bigjosh/Vibe-V2/board/Images/readme.md

These images are just here to enable GITHUB's visual diff.

They were created with the very handy CircuitPeople tool.
