bigjosh/Vibe-V2/board/Images/BoardOutline.gbr.png

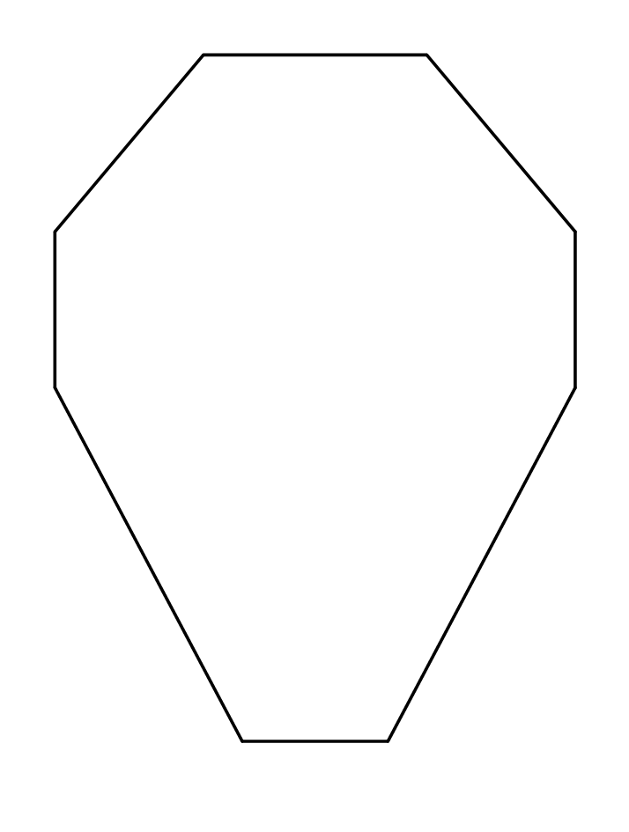
board/Images/BoardOutline.gbr.png
