bigjosh/Vibe-V2/board/Images/Bottom.gbr.png

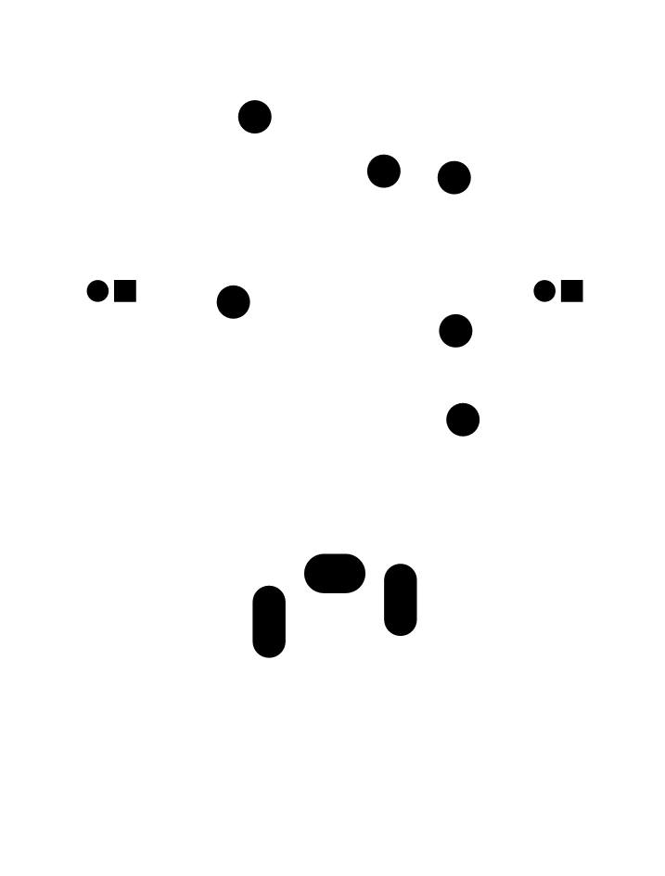
board/Images/Bottom.gbr.png
