bigjosh/Vibe-V2/board/Images/BottomMask.gbr.png

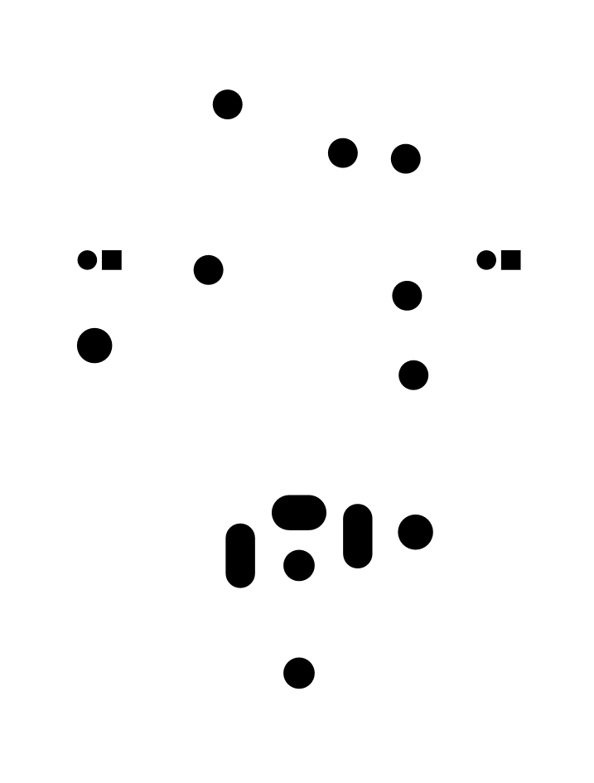
board/Images/BottomMask.gbr.png
