bigjosh/Vibe-V2/board/Images/BottomSilk.gbr.png

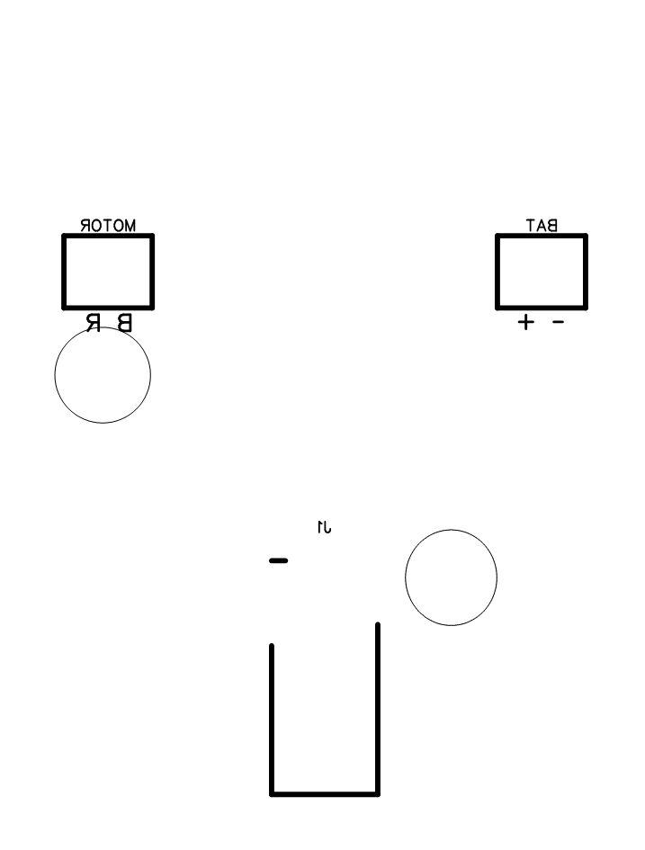
board/Images/BottomSilk.gbr.png
