bigjosh/Vibe-V2/board/Images/Top.gbr.png

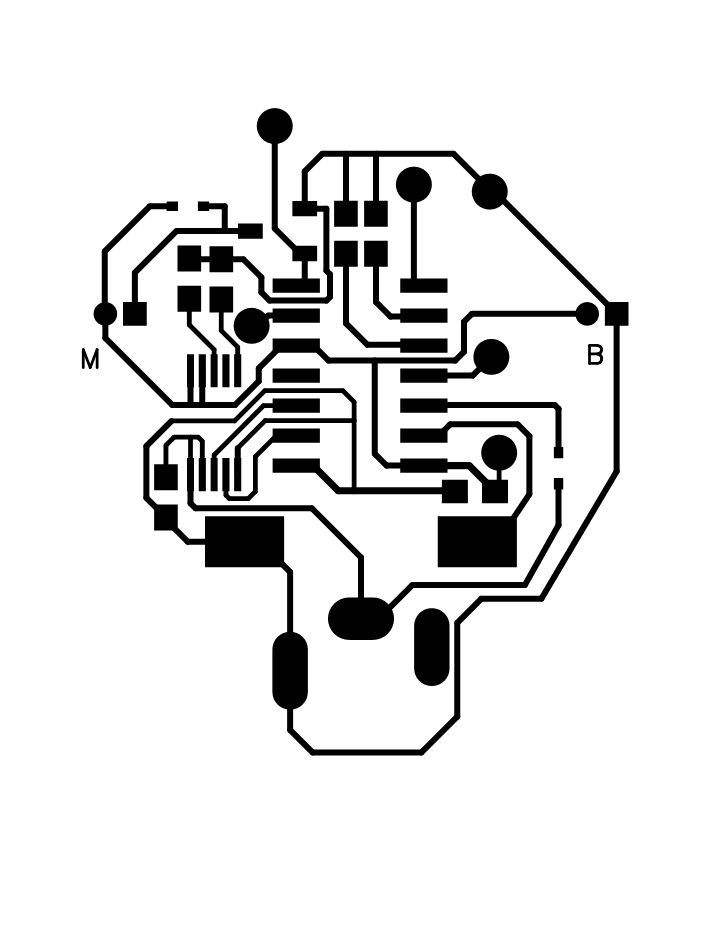
board/Images/Top.gbr.png
