bigjosh/Vibe-V2/board/Images/TopMask.gbr.png

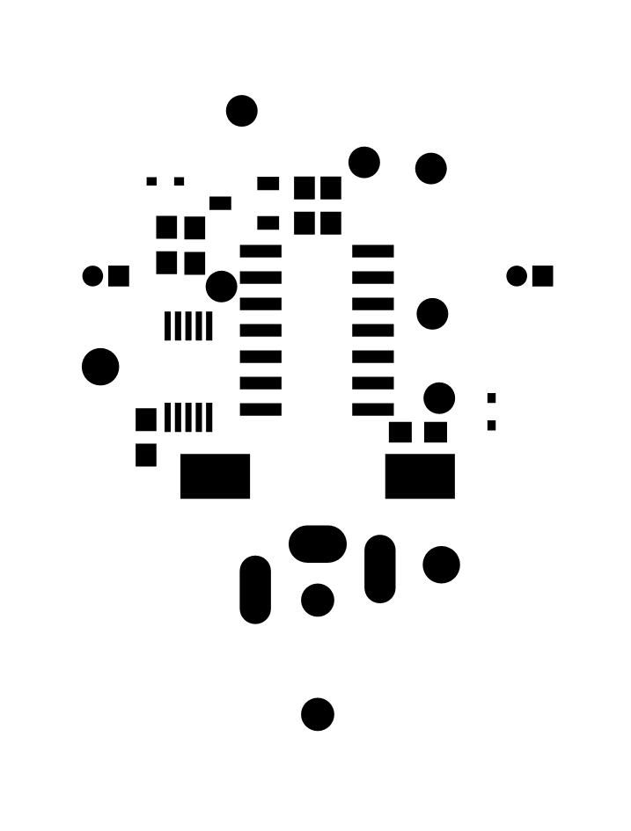
board/Images/TopMask.gbr.png
