bigjosh/Vibe-V2/board/Images/TopPaste.gbr.png

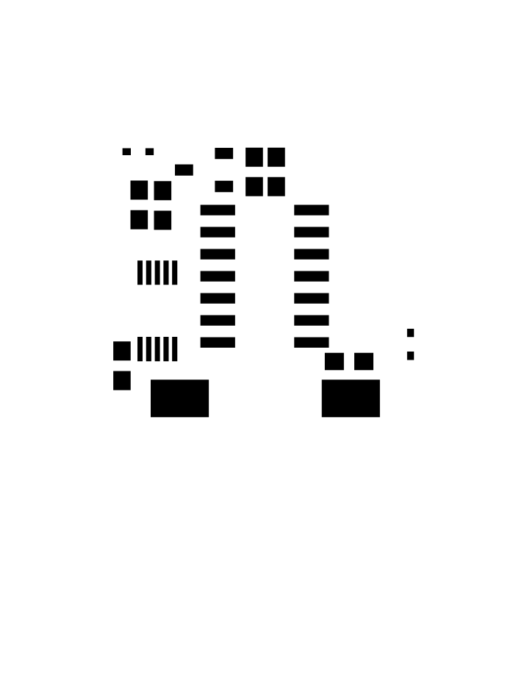
board/Images/TopPaste.gbr.png
