bigjosh/Vibe-V2/board/Images/TopSilk.gbr.png

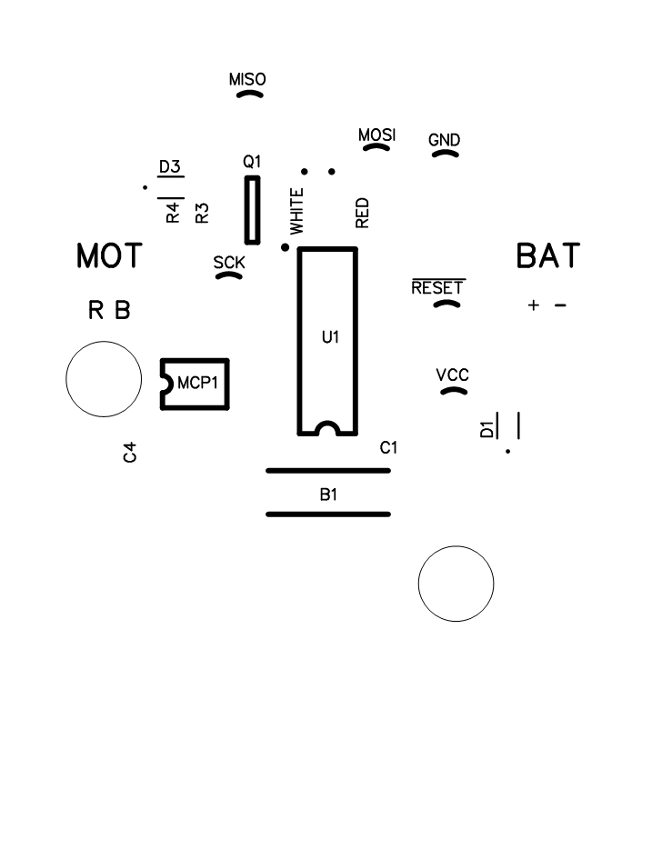
board/Images/TopSilk.gbr.png
