bigjosh/Vibe-V2/board/Orientation Photos/Diode D1 Orientation Photo..JPG

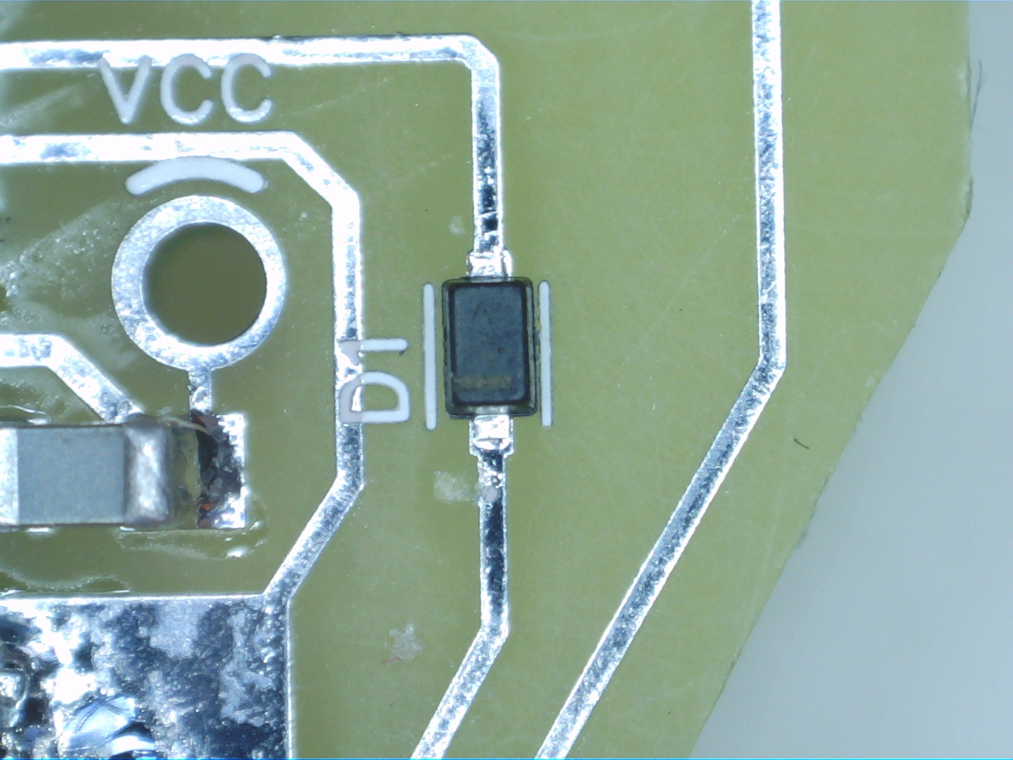
board/Orientation Photos/Diode D1 Orientation Photo..JPG
