bigjosh/Vibe-V2/board/Orientation Photos/Diode D3 Orientation Photo.JPG

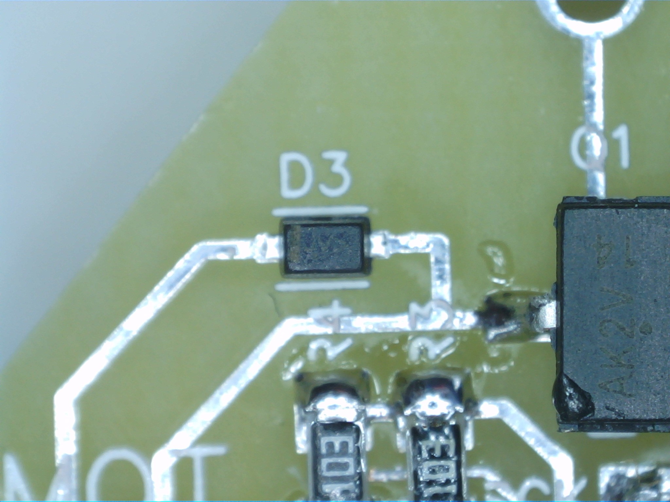
board/Orientation Photos/Diode D3 Orientation Photo.JPG
