bigjosh/Vibe-V2/board/Orientation Photos/LED Orientation Photo.JPG

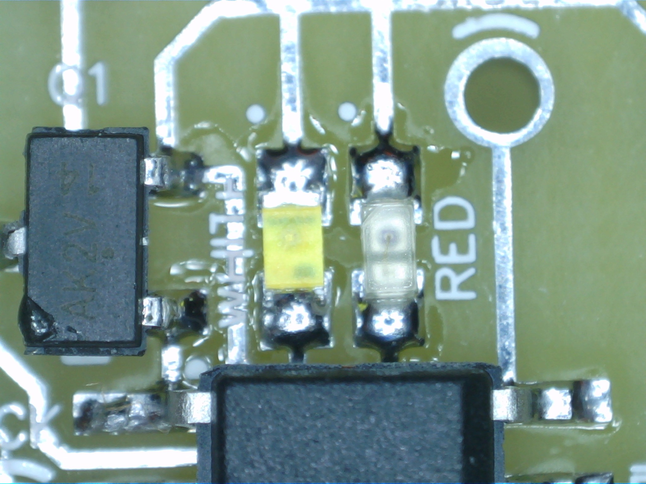
board/Orientation Photos/LED Orientation Photo.JPG
