bigjosh/Vibe-V2/board/Preview.PNG

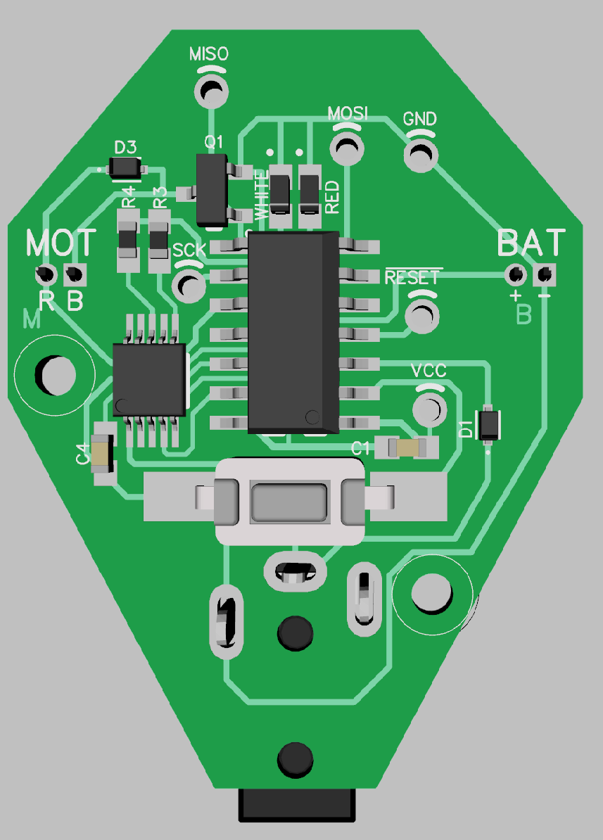
board/Preview.PNG
