bigjosh/Vibe-V2/board/BOM/Notes.txt

These 3 files contain the same information in different formats. 

A live version of the BOM is available at...

https://docs.google.com/spreadsheets/d/1DJ4L0mpyu5pduNasJa129-OpFUWWm2bzT5Ja490cZhg/edit?usp=sharing
