bigjosh/Vibe-V2/programming jigs/vibe_v2_programming_jig_guide_ramps.stl

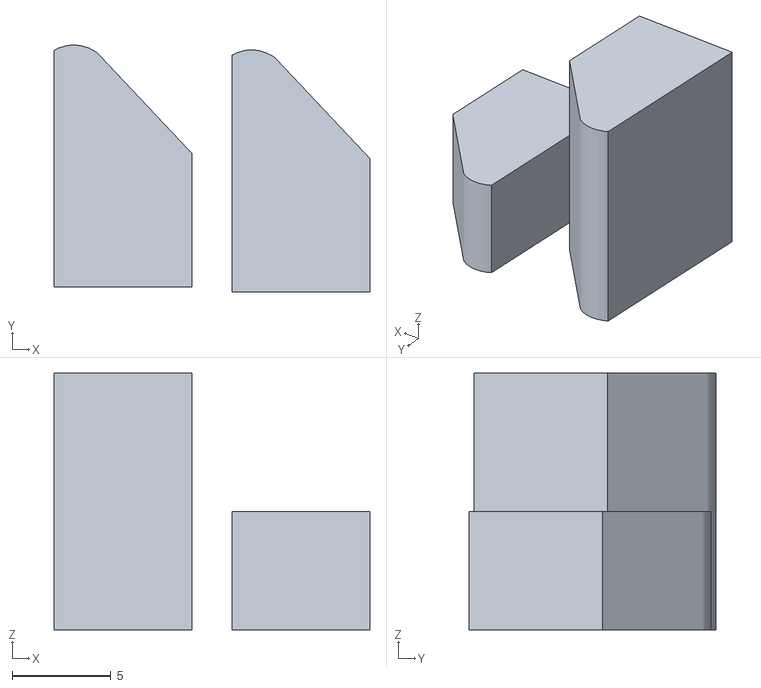
[picture p14: CAD file, 2015-01-11]
programming jigs/vibe_v2_programming_jig_guide_ramps.stl
16.0 x 12.5 x 13.0
