bigjosh/Vibe-V2/board/Vibe Schematic.pdf

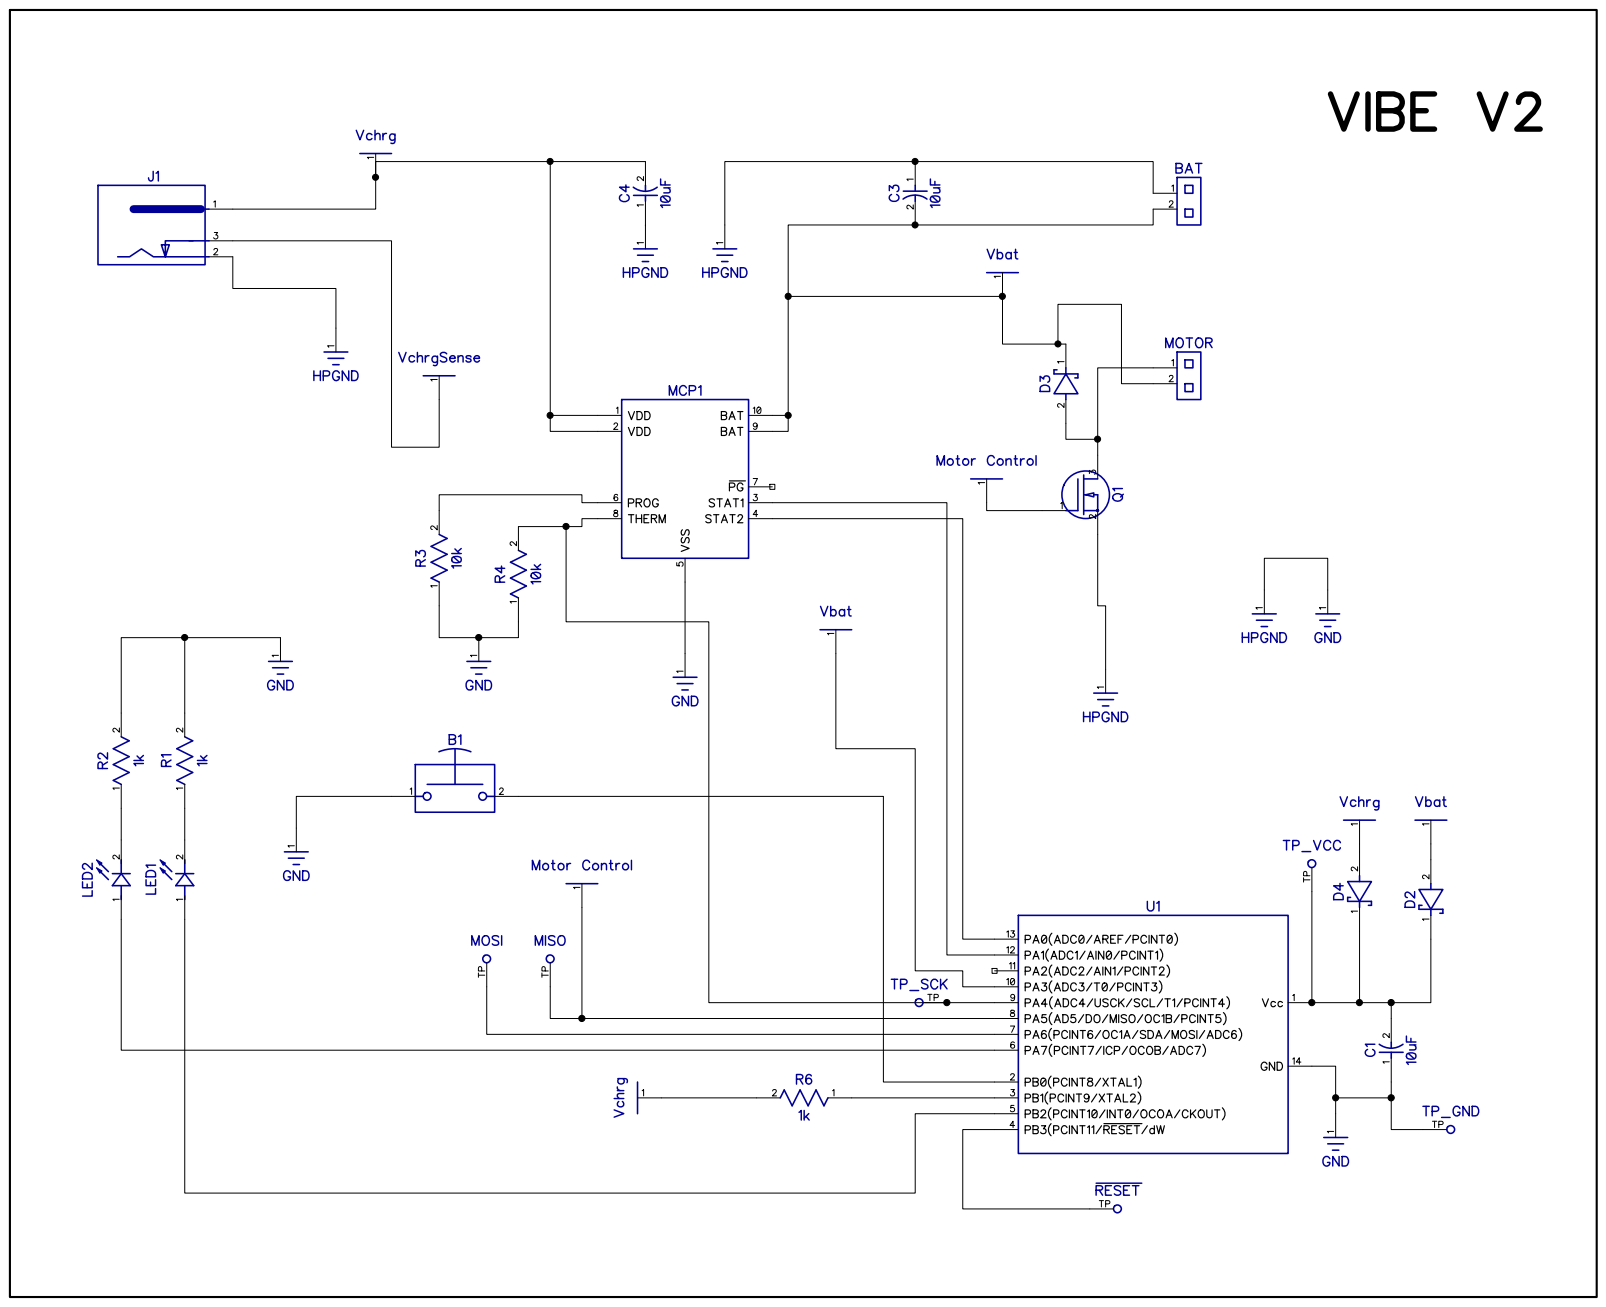
[picture p18: page 1]
