bigjosh/Vibe-V2/board/Vibe Drawing Bottom.pdf

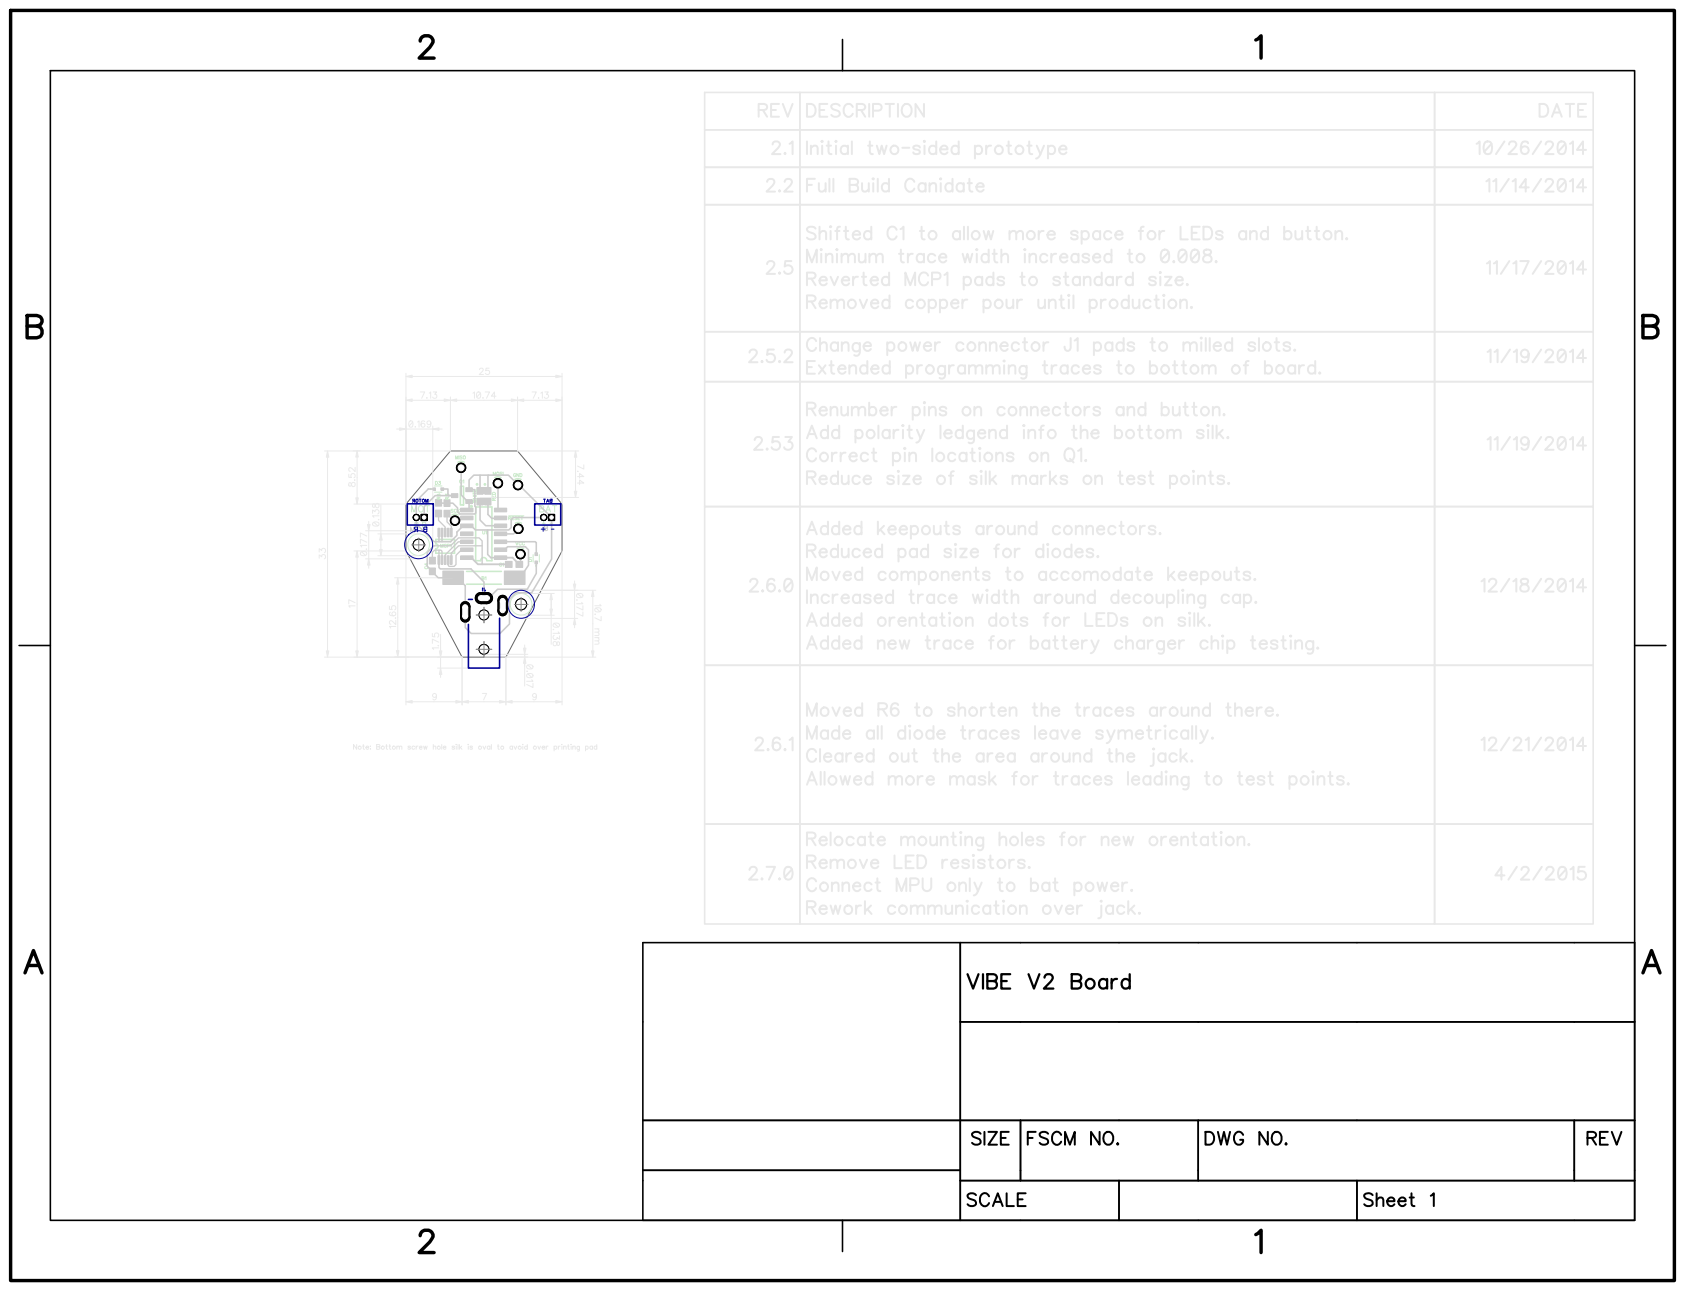
[picture p19: page 1]
