bigjosh/Vibe-V2/board/Vibe Drawing.pdf

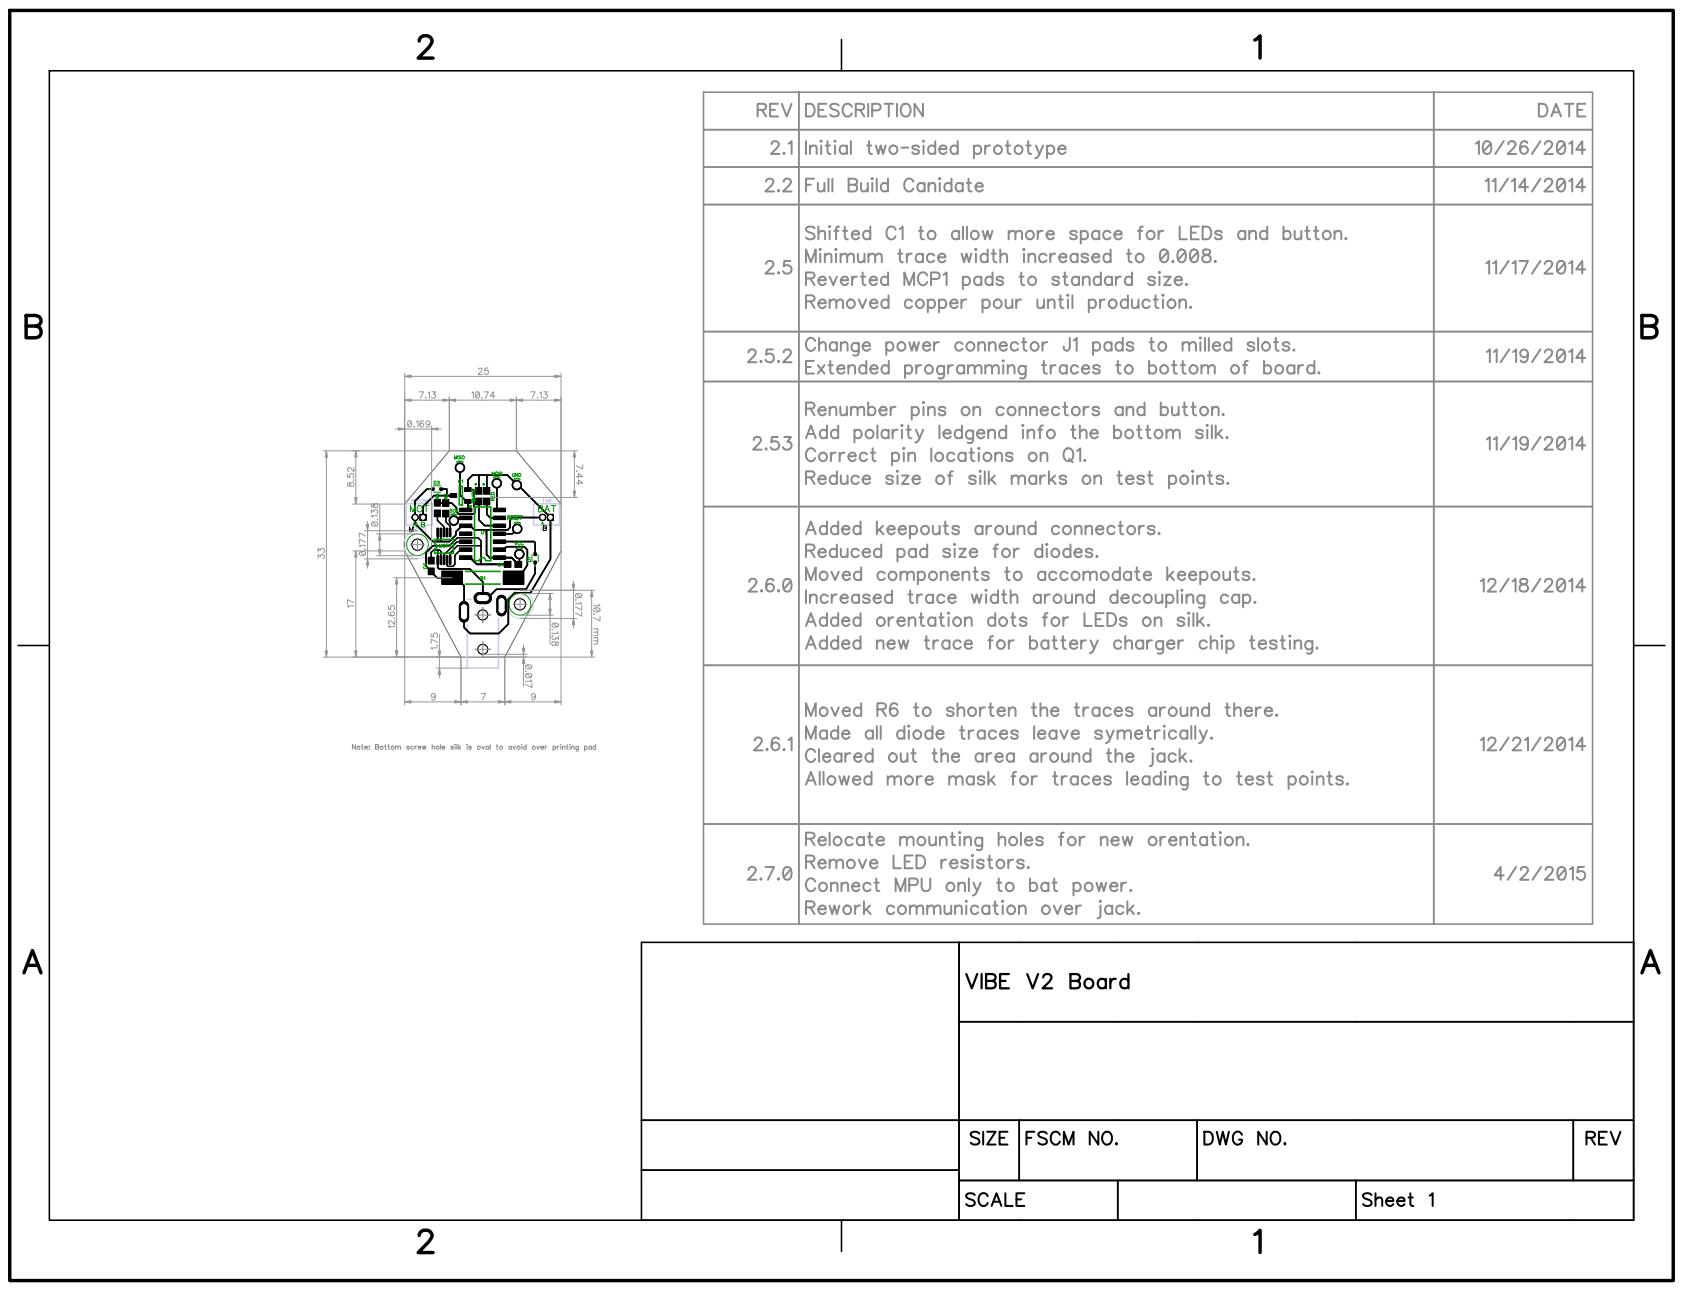
[picture p20: page 1]
