bigjosh/Vibe-V2/(list of files, drawings)

Other design files:
board/Design Files/Vibe Working base.dch
board/Design Files/Vibe working base.dip
programming jigs/design files/Vibe working programming jig laver 1 board 10 pin front.dip
programming jigs/design files/Vibe working programming jig laver 2 board 10 pin front.dip
programming jigs/design files/Vibe working programming jig laver 3 board 10 pin front.dip
programming jigs/design files/Vibe working programming jig laver 4 board 10 pin front spear pin holes.dip
programming jigs/design files/Vibe working programming jig laver 4 board 10 pin front.dip
