bigjosh/Vibe-V2/(commit log)

2014-11-30 Added board files
    These are a snapshot of the 2.5.3 board rev
    [Vibe Working base.dch, Vibe working base.dip]
2014-11-30 Added board notes
2014-12-01 Starter test code
    Sleeps, blinks LEDs, test button.
2014-12-01 Basic motor functionality
    Button press cycles though preset motor speeds. LEDs alternate on each
    press. Full debounce implemented.
2014-12-04 Test mode, slow start, shorter long press
    [Vibe V2 firmware.c]
2014-12-12 Added programming jigs
    [Vibe working pogo jig 6 pin back.dip, Vibe working pogo jig bottom board 10 pin back.dip, Vibe working pogo jig bottom board 6 pin back.dip]
2014-12-19 Board version 2.5.2
    1) Board now has 2 copper layers with associated files.
    2) Power connector J1 now has slotted pads and holes.
    3) All holes now have pads on both sides and are plated though.
    4) A couple of traces are extended to the bottom of the board (no change
    to nets).
    [Vibe Working base.dch, Vibe working base.dip]
2014-12-19 Board Version 2.5.3
    1) I’ve included a full set of layers, but note that the bottom paste
    layer is intentionally empty. This assumes that you will be reflowing
    this board and probably using solder preforms on the through holes
    parts. If you need a bottom paste layer, just let me know what you’d
    like and I’ll whip one up!
    2) I cleaned up the screens and so they do not touch any traces or pads.
    3) I’ve added a note to the notes.txt indicating that the silk layers
    are for reference and for test boards, and are not required on the
    production version of the board.
    [Vibe Working base.dch, Vibe working base.dip]
2014-12-19 Board Version 2.6.0
    1. Used a (much!) smaller SOD-523 mounting pad footprint for Diodes D1,
    D2, and D3 to fix lots of reflow problems.
    2. Added a 5mm part keep-out around connectors MOTOR and BAT to allow
    room for selective soldering nozzle.
    3. Moved parts D3 and Q1 to get them out of the new keep-outs around
    connector MOTOR added above. In the process...
    a) We lost resistor R5 to make room. This resistor was optional and will
    not be missed.
    b) I had to move test point MISO to make room. This means we will need
    new programming jigs, which I will make sure Walter gets before he needs
    them.
    4. Moved diodes D2 and D4 to get them out of the new keep out around
    connector BAT added above.
    5.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
    [Vibe Working base.dch, Vibe working base.dip, Vibe_BOM - Sheet1.csv, Vibe_BOM.xlsx]
2014-12-22 Board Version 2.6.1
    Moved C4 so it is nowhere near the jack soldering area.
    Made leads to diodes symmetrical for better reflow.
    Added more mask area for test points VCC and SCK.
    [Vibe Working base.dch, Vibe working base.dip]
2015-01-02 Newest board version
    [Vibe working base.dip]
2015-01-02 Added jack
    Now the jack gets pulled up to power a slave device.
2015-01-02 Timer0 working - LEDs connected and fade-able
    Timer0 is running at about 433Hz and the LEDs are connected to it so it
    can PWM their brightness 0-255.
    The startup blinking is now startup fading. I think the blinking looks
    nicer.
2015-01-03 Improved start-up testing
    Now lets to see blink pattern on every startup and also tests for and
    indicated stuck button.
    [Vibe V2 firmware.c]
2015-01-05 Catch bad interrupts, disable stuck button
    Cleaned up white led code
    [Vibe V2 firmware.c]
2015-01-09 Added Calibration Controller
2015-01-11 Updated jig files
    [Vibe working pogo jig 6 pin back.dip, Vibe working pogo jig bottom board 10 pin back.dip, Vibe working pogo jig bottom board 6 pin back.dip, Vibe working programming jig laver 1 board 10 pin front.dip, Vibe working programming jig laver 2 board 10 pin front.dip, Vibe working programming jig laver 3 board 10 pin front.dip, Vibe working programming jig laver 4 board 10 pin front.dip, vibe_v2_progra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]
2015-01-13 Gut Rehab
    Completely rewrote code from ground up. Two big pushes were (1) reduce
    complexity so everything except core functionality is gone, and (2) add
    watchdog resets after every state change to hopefully make the units
    more robust to failures.
    [Vibe V2 firmware.c]
2015-01-15 New spear tip programming jig
    [Vibe working programming jig laver 4 board 10 pin front spear pin holes.dip]
2015-01-15 Added battery charger fixture schematic
2015-01-15 Added flyback testing circuit
2015-01-15 added flyback circuit. cleaned up text.
2015-01-15 new bat charger image
2015-01-15 better bat charger diagram
2015-01-16 Updated layer 4 board spear hole
    [Vibe working programming jig laver 4 board 10 pin front spear pin holes.dip]
2015-01-22 New stuck button behavior
    Now there are two phases before we enter stuck button lockout- the first
    lasts for 8 seconds and the white LED is on solid, then we switch to
    stuck button warming mode which lasts for about 30 minutes and during
    which the while LED flashes for about 100ms every second.
    [Vibe V2 firmware.c]
2015-01-22 Update stuck button mode to reflect new software version
2015-01-22 Add link for stuck button defense
2015-01-22 Updated for new stuck-button behavior.
2015-04-03 Test new button timing
    Test to see how it feels with speed changes on button up events
2015-04-04 Board update
    Moved mounting holes. Removed LED resistors. Powered CPU directly from
    battery. Reworked communication over power connector.
    [Vibe Working base.dch, Vibe working base.dip]
2015-04-16 New Board Version 2.7.0
    1. **Moved mounting holes **to accommodate new shell configuration.
    2. **Eliminated parts R1 and R2**. These were there to protect the LEDs
    from being overdriven in software. Because we are not allowing user
    uploaded code, these are no longer necessary. LEDs are now driven
    directly with very low duty PWM which saves parts and power..
    3. **Eliminated parts R6 and D4**. These were there to allow the vibe to
    be powered directly from the power jack without a battery present for
    testing, but we turned out to not use this feature.
    4. **Further increased the keep-out clearance around the ****through****
    hole parts**. This takes advantage of some space we opened up by movi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
    [Vibe Working base.dch, Vibe working base.dip, Vibe_BOM - Sheet1.csv, Vibe_BOM.xlsx]
2015-04-16 New button behavior
    Now speed change only happens on button release rather than press. This makes it possible to go straight to off without stepping to next higher speed in the process.
2015-04-22 Increase LED PWM frequency *8
    Reduced the prescaller from 8 to 1. Blinking the LED with shorter pulses
    will hopefully will reduce the maximum current though it and improve
    endurance?
    [Vibe V2 firmware.c]
2015-05-01 Added diode image for controller
2015-05-01 Updated calibration controller readme
    * Updated preset speed values to reflect current firmware
2015-11-06 Go into transmit mode (formerly stuck-button lockout) after 10 seconds held button
    [Vibe V2 firmware.c]
